RyanJMah/fydp-anchor-pcb/UWB_Anchor/Project Outputs for UWB_Anchor/BOM/Bill of Materials-UWB_Anchor.xlsx

Designator | Value | Footprint | Manufacturer | Manufacturer Part Number | Supplier | Supplier Part Number | Quantity
C1 | 22nF | 0603 - Capacitor | Samsung Electro-Mechanics | CL10B223KB8NNNC | JLCPCB | C21122 | 1
C2, C5 | 6.8nF | 0603 - Capacitor | FH (Guangdong Fenghua Advanced Tech) | 0603B682K500NT | JLCPCB | C1631 | 2
C3 | 1nF/2kV | 1206 - Capacitor | FH (Guangdong Fenghua Advanced Tech) | 1206B102K202NT | JLCPCB | C9196 | 1
C4, C33 | 10nF | 0603 - Capacitor | FH (Guangdong Fenghua Advanced Tech) | 0603B103K500NT | JLCPCB | C57112 | 2
C6 | 100uF | CAPPRD350W60D825H1300 | Lelon | RGA101M1HBK-0811G | Mouser | 140-RGA101M1HBK0811G | 1
C7, C8, C9, C19, C27, C28 | 10uF | 0603 - Capacitor | YAGEO | CC0603KRX7R9BB104 | JLCPCB | C14663 | 6
C10, C12, C20, C21, C22, C23, C24, C25, C26, C29 | 0.1uF | 0603 - Capacitor | YAGEO | CC0603KRX7R9BB104 | JLCPCB | C14663 | 10
C11, C14, C15, C16 | DNP | 0603 - Capacitor |  |  |  |  | 4
C13 | 1uF | 0603 - Capacitor | Samsung Electro-Mechanics | CL10A105KB8NNNC | JLCPCB | C15849 | 1
C17, C18 | 330pF | 0603 - Capacitor | Samsung Electro-Mechanics | CL10C331JB8NNNC | JLCPCB | C1664 | 2
C30, C31 | 10pF | 0603 - Capacitor | Samsung Electro-Mechanics | CL10C100JB8NNNC | JLCPCB | C1634 | 2
C32 | 4.7uF | 0603 - Capacitor | Samsung Electro-Mechanics | CL10A475KO8NNNC | JLCPCB | C19666 | 1
D1 |  | FP-SMAJ-MFG | Murata Electronics | BLM21AG121SH1D | Mouser | 81-BLM21AG121SH1D | 1
D2, D3, D4, D5, D6 |  | 0805 LED | Foshan NationStar Optoelectronics, Hubei KENTO Elec | NCD0805R1, C2297, C2296 | JLCPCB | C84256, C2297, C2296 | 5
F1, F2 |  | Wurth_0_MFG | Wurth Elektronik | 696101000002 | Mouser | 710-696101000002 | 2
FB1 |  | FP-BLM21-0_2-t0_85-e0_5-MFG | Murata Electronics | BLM21AG121SH1D | Mouser | 81-BLM21AG121SH1D | 1
J1 |  | ARJP11A-MASA-B-A-EMU2 | ABRACON | ARJP11A-MASA-B-A-EMU2 | Mouser | 815-RJP11AMASABAEMU2 | 1
J2 |  | HDR1X4 |  |  |  |  | 1
J3 |  | HDR1X3 |  |  |  |  | 1
J4, J5, J6, J7, J8, J9 |  | HDR1X2 |  |  |  |  | 6
L1 |  | FP-DFE252010C-IPC_A | Murata Electronics | DFE252010P-2R2M=P2 | JLCPCB | C882952 | 1
Q1, Q2 |  | ONSC-SOT-23-3-318-08_V | On Semiconductor | MGSF2N02ELT1G | JLCPCB | C236232 | 2
R1, R2, R15, R16, R17, R18, R19, R22, R23 | 1k | 0603 - Resistor | UNI-ROYAL(Uniroyal Elec) | 0603WAF1001T5E | JLCPCB | C21190 | 9
R3, R7, R8, R12 | 49.9 | 0603 - Resistor | UNI-ROYAL(Uniroyal Elec) | 0603WAF499JT5E | JLCPCB | C23185 | 4
R4, R6, R9, R11 | 33 | 0603 - Resistor | UNI-ROYAL(Uniroyal Elec) | 0603WAF330JT5E | JLCPCB | C23140 | 4
R5 | 10 | 0603 - Resistor | UNI-ROYAL(Uniroyal Elec) | 0603WAF100JT5E | JLCPCB | C22859 | 1
R10 | 0 | 0603 - Resistor | UNI-ROYAL(Uniroyal Elec) | 0603WAF0000T5E | JLCPCB | C21189 | 1
R13, R14 | 100 / 0.25W | RESAD1100W55L680D260 |  |  |  |  | 2
R20, R21, R34 | DNP | 0603 - Resistor |  |  |  |  | 3
R24, R25 | 100k | 0603 - Resistor | UNI-ROYAL(Uniroyal Elec) | 0603WAF1003T5E | JLCPCB | C25803 | 2
R26 | 1M | 0603 - Resistor | UNI-ROYAL(Uniroyal Elec) | 0603WAF1004T5E | JLCPCB | C22935 | 1
R27, R28, R30, R31, R32, R33, R35 | 10k | 0603 - Resistor | UNI-ROYAL(Uniroyal Elec) | 0603WAF1002T5E | JLCPCB | C25804 | 7
R29 | 2.4k | 0603 - Resistor | UNI-ROYAL(Uniroyal Elec) | 0603WAF2401T5E | JLCPCB | C22940 | 1
S1, S2 |  | SW_TS-1187A-B-A-B | XKB Connectivity | TS-1187A-B-A-B | JLCPCB | C318884 | 2
U1 |  | Ag9900m | Silvertel | Ag9905M | Mouser | 480-AG9905M | 1
U2 |  | DCY0004A_N | Texas Instruments | TLV1117LV33DCYR | JLCPCB | C15578 | 1
U3 |  | DWM3001C | Qorvo | DWM3001C | Qorvo | DWM3001C | 1
U4 |  | W5500 | WIZNET | W5500 | JLCPCB | C32843 | 1
Y1 | 25MHz | XTAL_TSX-3225_25.0000MF20P-C0 | Yangxing Tech | X322525MOB4SI | JLCPCB | C9006 | 1
