RyanJMah/fydp-anchor-pcb/UWB_Anchor/Project Outputs for UWB_Anchor/PDF/UWB_Anchor.PDF

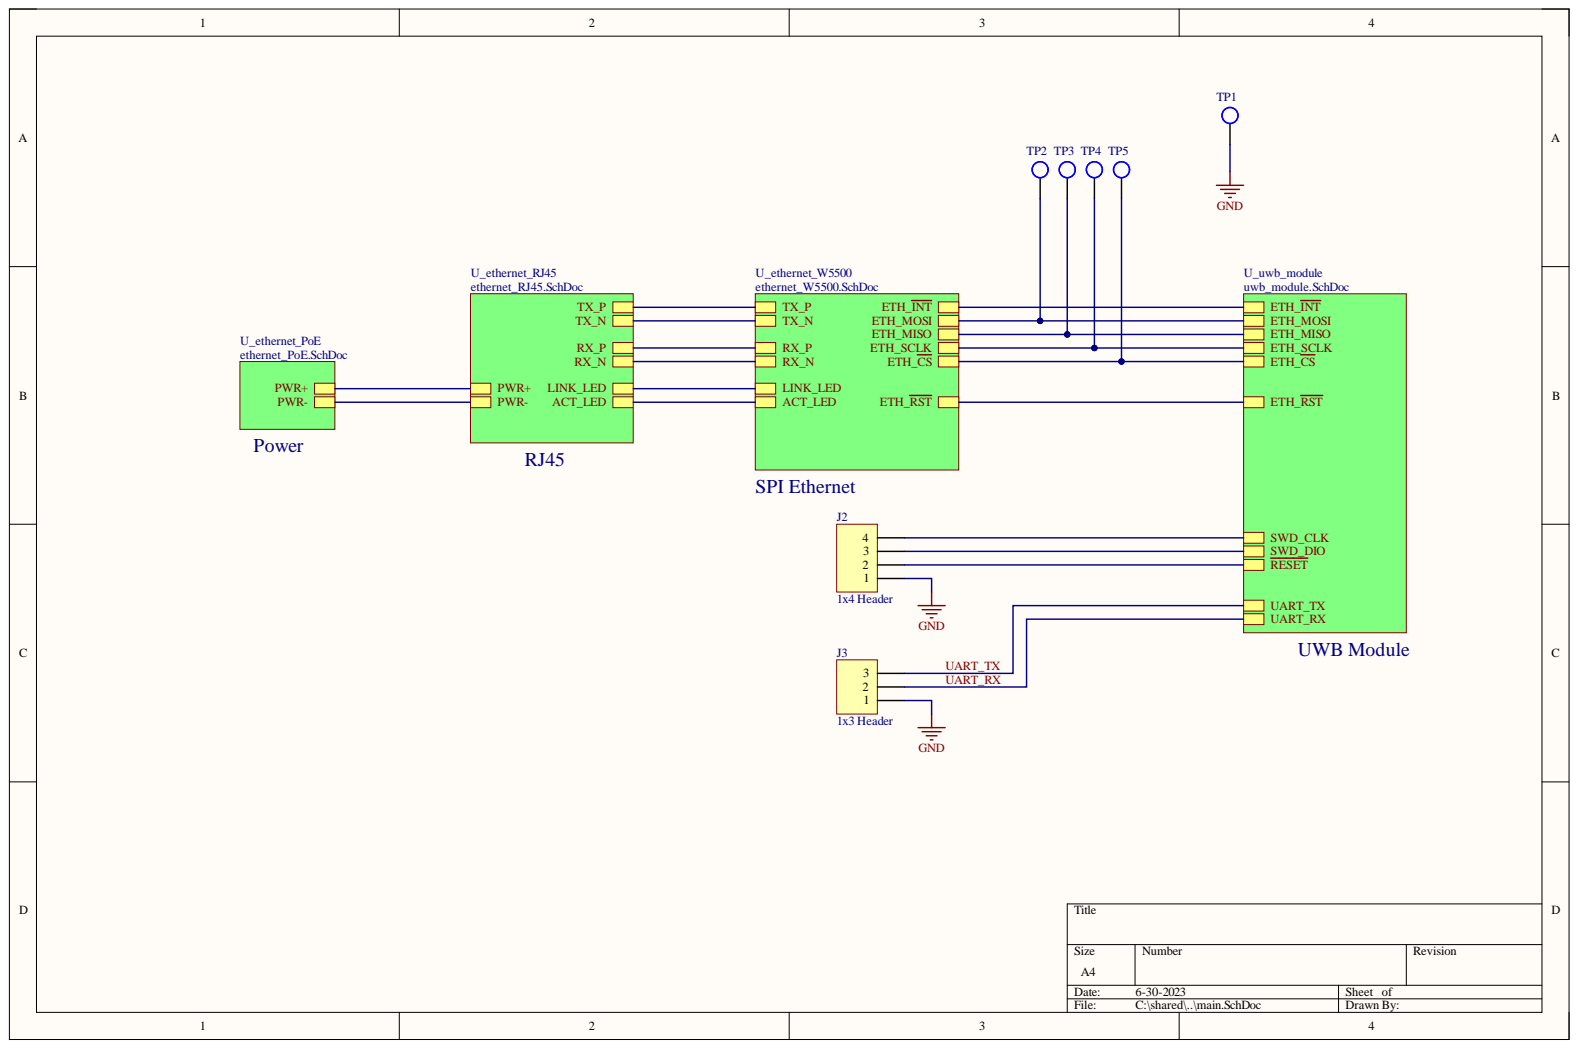
[picture p1: page 1]

Size A4 | Number | Revision

Date: 6-30-2023 | Sheet of
File: C:\shared\..\main.SchDoc | Drawn By:

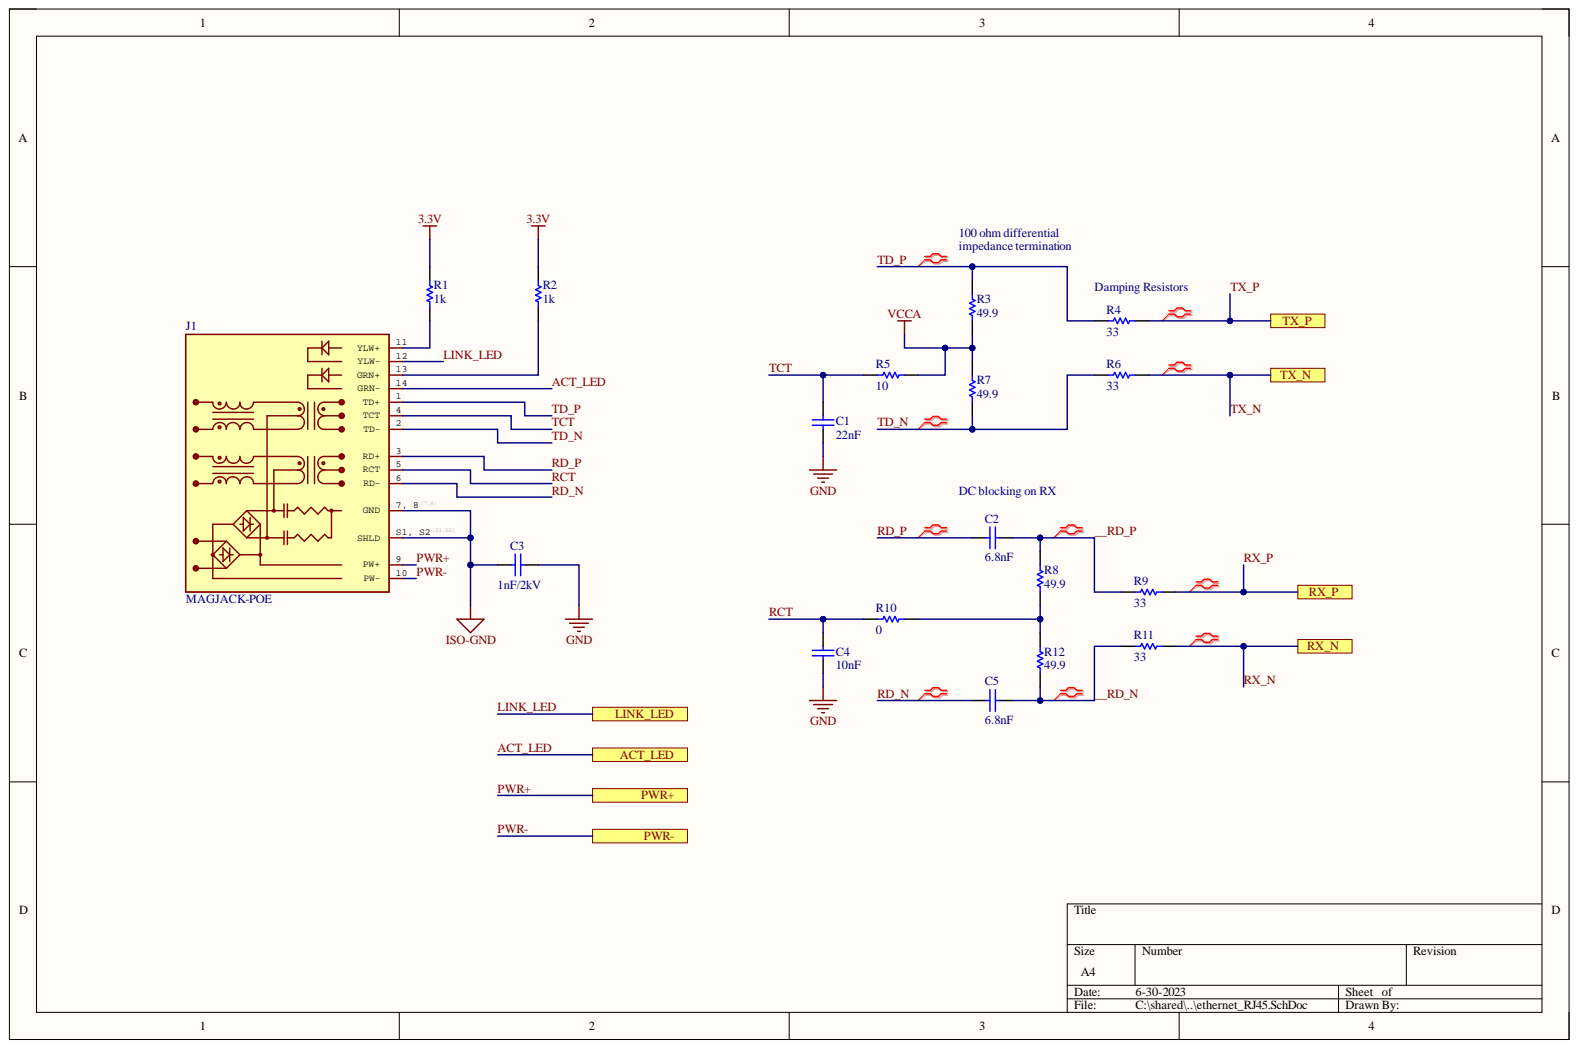
[picture p2: page 2]

Siz e A4 | Numb e r | R evisio n

Da te : 6-30-2 0 2 3 | She et of
File : C:\sha r ed\. .\ethe rnet_R J4 5 . S c hD o c | Dr awn By:

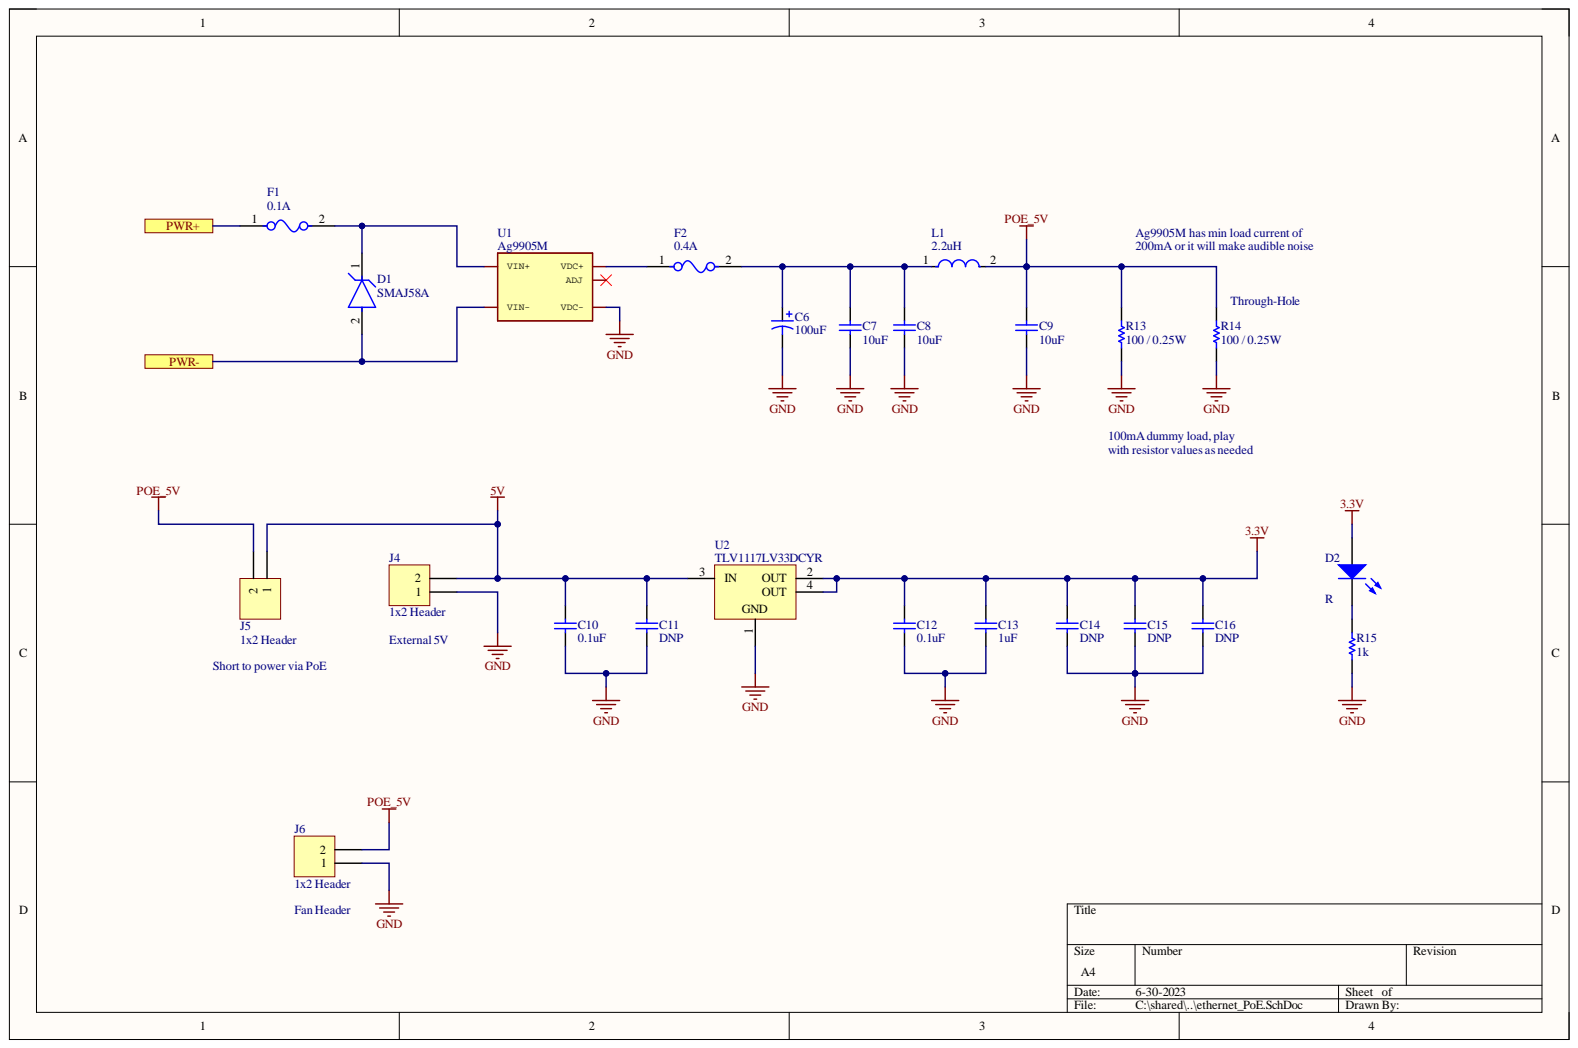
[picture p3: page 3]

Ag9905M has min load current of
200mA or it will make audible noise

100mA dummy load, play
with resistor values as needed

Size A4 | Number | Revision

Date: 6-30-2023 | Sheet of
File: C:\shared\..\ethernet_PoE.SchDoc | Drawn By:

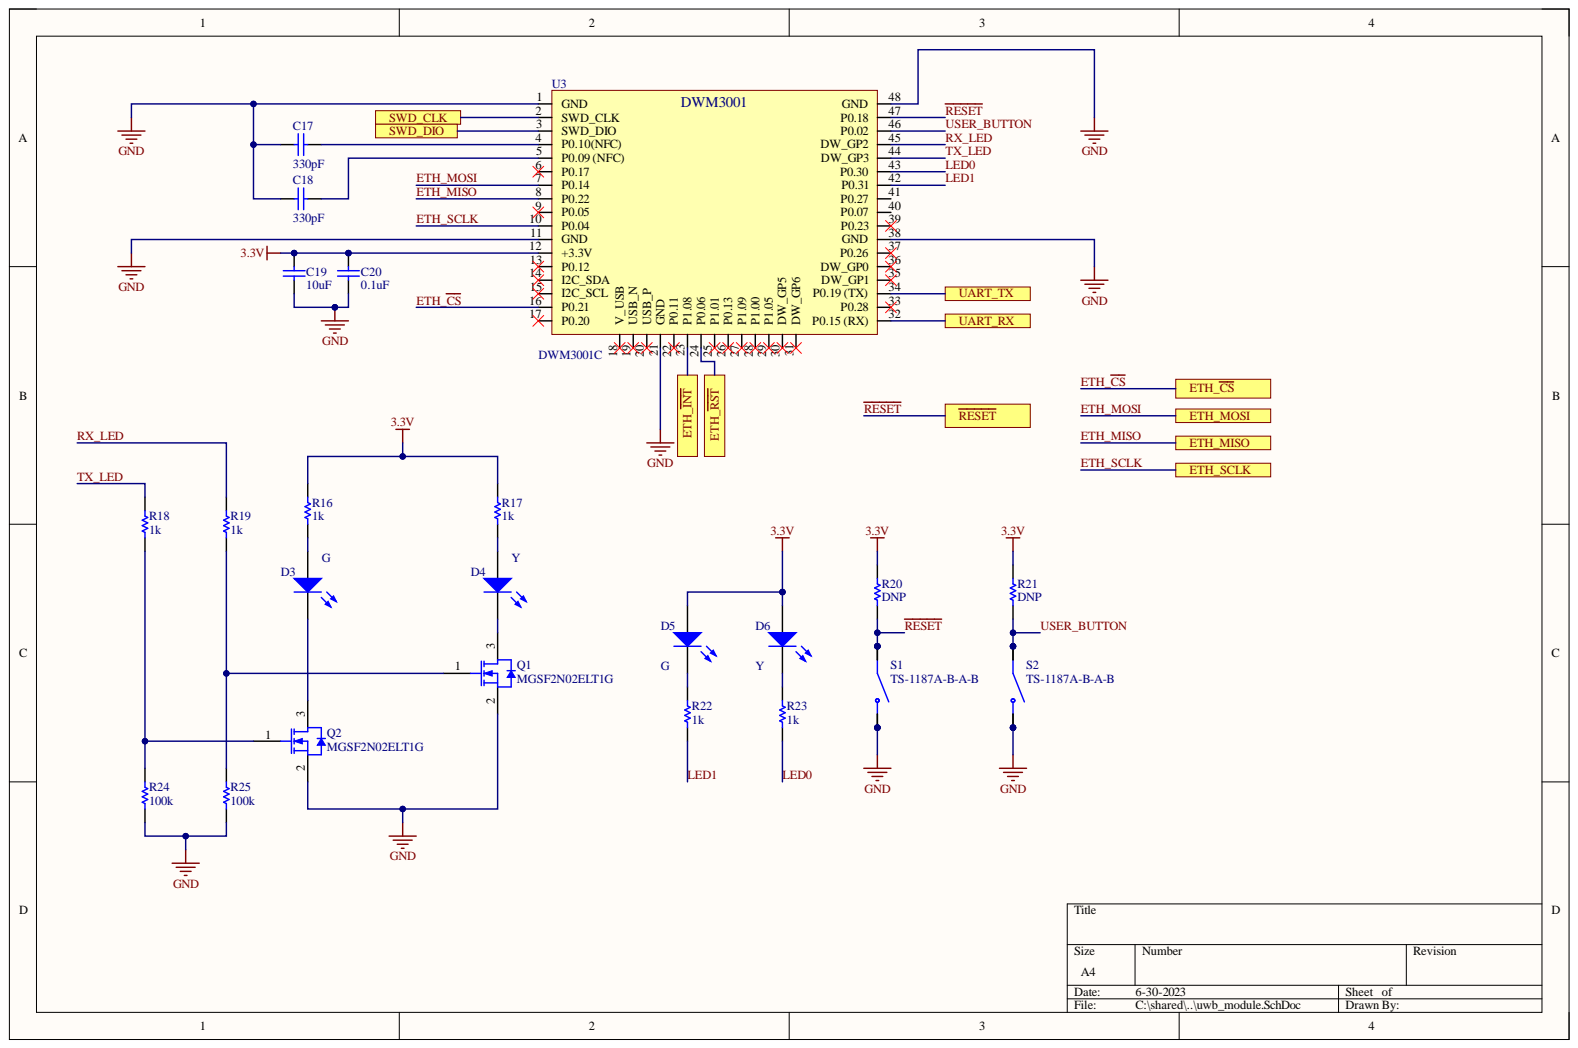
[picture p4: page 4]

Siz e A4 | Numb e r | R evisio n

Da te : 6-30-2 0 2 3 | She et of
File : C:\sha r ed\. .\uwb_modul e . S c hD o c | Dr awn By:

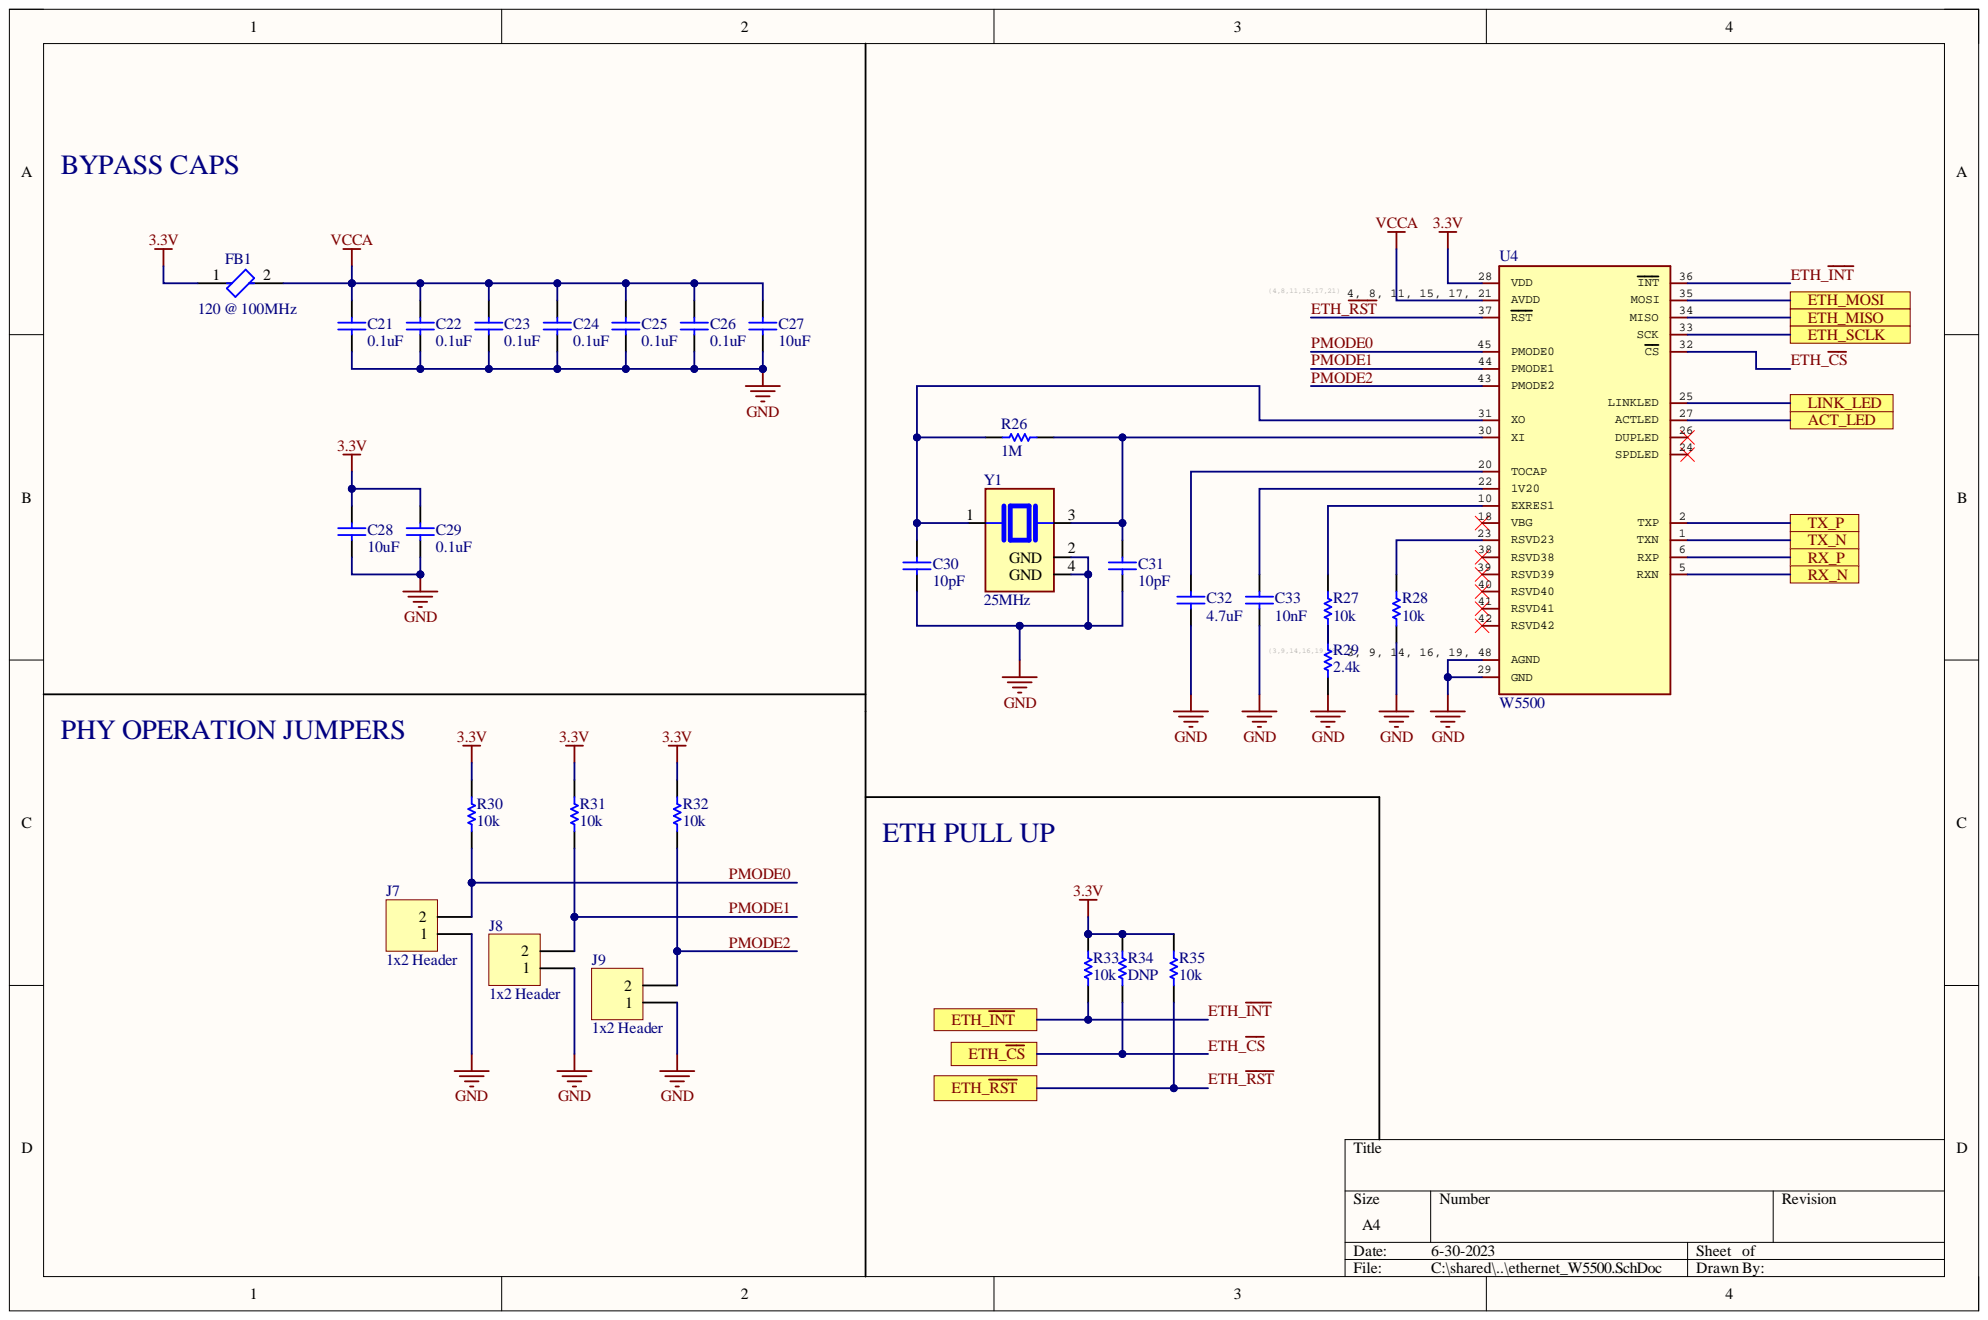
[picture p5: page 5]

1V20 22
EXRES1 10
VBG 18

Siz e A4 | Numb e r | R evisio n

Da te : 6-30-2 0 2 3 | She et of
File : C:\sha r ed\. .\ethe rnet_W 5 5 0 0 . S c hD o c | Dr awn By:

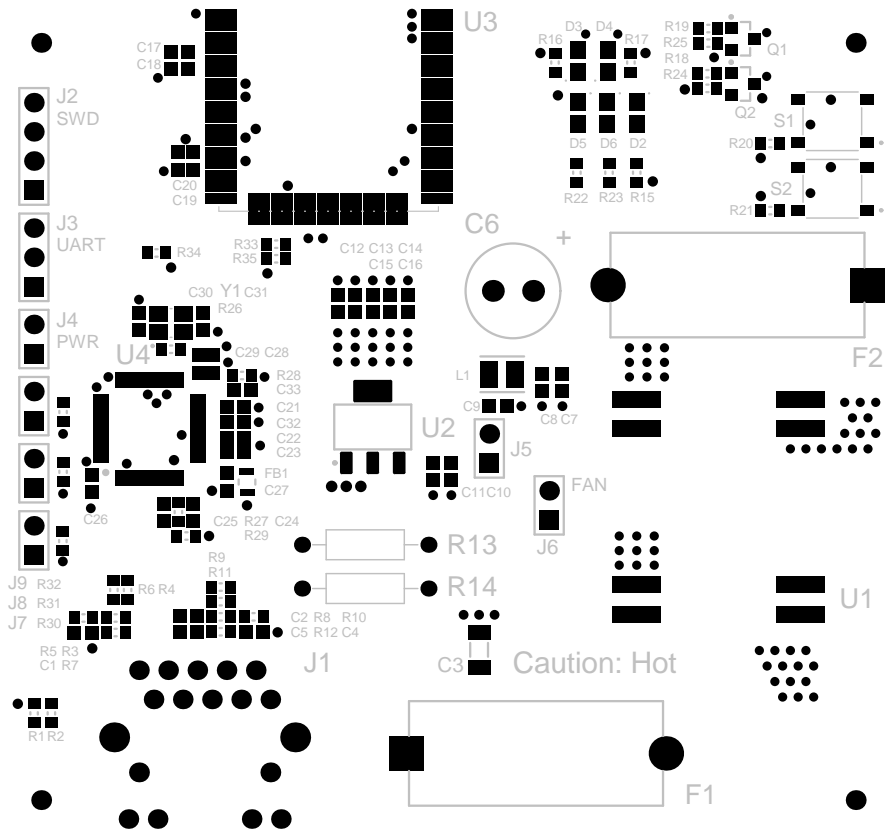
[picture p6: page 6]

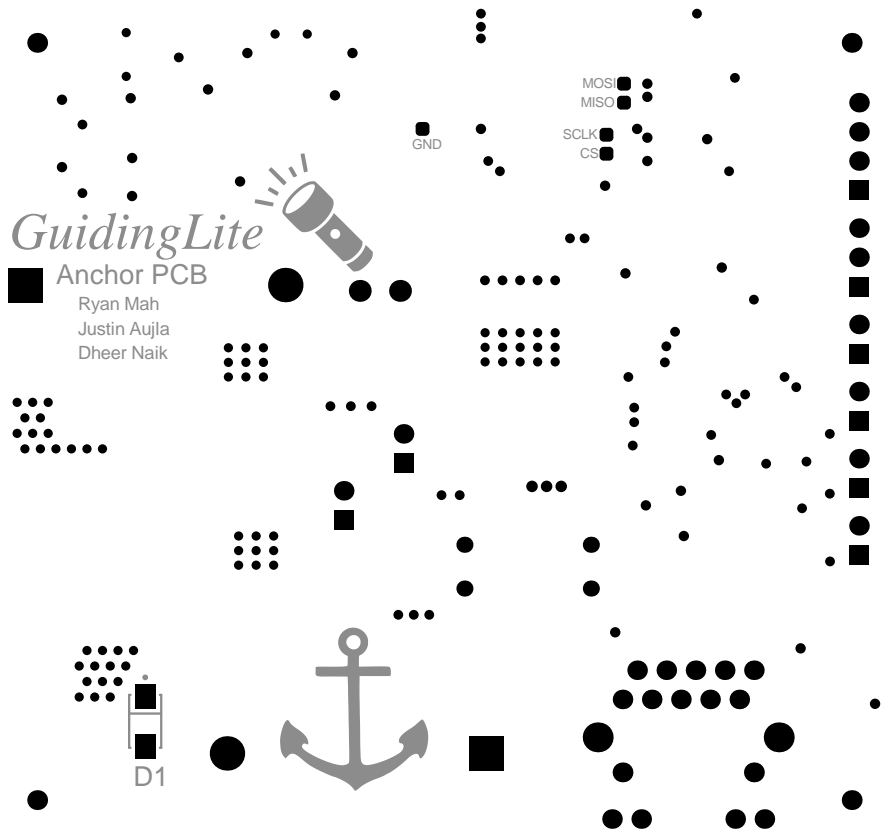
[picture p7: page 7]
