RyanJMah/fydp-anchor-pcb/(list of files, drawings)

Other design files:
UWB_Anchor/board.PcbDoc
UWB_Anchor/ethernet_PoE.SchDoc
UWB_Anchor/ethernet_RJ45.SchDoc
UWB_Anchor/ethernet_W5500.SchDoc
UWB_Anchor/main.SchDoc
UWB_Anchor/UWB_Anchor.PrjPcb
UWB_Anchor/uwb_module.SchDoc
