RyanJMah/fydp-anchor-pcb/(commit log)

2023-06-02 I fucked up and had to force push but if u have a problem with that then fuck u
    [UWB_Anchor.PrjPcb, ethernet.SchDoc, main.SchDoc]
2023-06-02 more ethernet changes
    [UWB_Anchor.PrjPcb, ethernet.SchDoc, ethernet_RJ45.SchDoc, main.SchDoc]
2023-06-03 idk what I did tbh
    [UWB_Anchor.PrjPcb, ethernet_PoE.SchDoc, ethernet_RJ45.SchDoc, main.SchDoc]
2023-06-04 added dwm schematic
    [uwb_module.SchDoc]
2023-06-05 merged dheer into master
    [main.SchDoc]
2023-06-06 pushing so justin can merge
    [UWB_Anchor.PrjPcb, ethernet_PoE.SchDoc, ethernet_RJ45.SchDoc, main.SchDoc, uwb_module.SchDoc]
2023-06-06 w5500 sch
    [ethernet_W5500.SchDoc]
2023-06-06 ryans problem now
    [ethernet_W5500.SchDoc, main.SchDoc, uwb_module.SchDoc]
2023-06-06 deez nuts
    [UWB_Anchor.PrjPcb, main.SchDoc]
2023-06-11 added outjob, fixed schematic lib ports, and re-annotated
    [UWB_Anchor.PrjPcb, ethernet_PoE.SchDoc, ethernet_RJ45.SchDoc, ethernet_W5500.SchDoc, uwb_module.SchDoc]
2023-06-11 passives for rj45 and w5500
    [ethernet_RJ45.SchDoc, ethernet_W5500.SchDoc]
2023-06-11 make ports not ugly
    [ethernet_PoE.SchDoc, ethernet_RJ45.SchDoc, ethernet_W5500.SchDoc, uwb_module.SchDoc]
2023-06-11 finished schematics (some passives still need spec tho)
    [UWB_Anchor.PrjPcb, ethernet_PoE.SchDoc, ethernet_RJ45.SchDoc, ethernet_W5500.SchDoc, main.SchDoc, uwb_module.SchDoc]
2023-06-11 i lied
    [ethernet_PoE.SchDoc, ethernet_W5500.SchDoc]
2023-06-12 done I think
    [UWB_Anchor.PrjPcb, ethernet_PoE.SchDoc, ethernet_RJ45.SchDoc, ethernet_W5500.SchDoc, main.SchDoc, uwb_module.SchDoc]
2023-06-12 import schematics into pcb
    [UWB_Anchor.PrjPcb, board.PcbDoc, main.SchDoc]
2023-06-13 started placement
    [UWB_Anchor.PrjPcb, board.PcbDoc, ethernet_W5500.SchDoc, uwb_module.SchDoc]
2023-06-24 clean up
    [UWB_Anchor.PrjPcb]
2023-06-24 idk what i did
    [Bill of Materials-UWB_Anchor.xlsx, Pick Place for board.csv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]
2023-06-24 jlc pick and place seems to kinda work
    [Bill of Materials-UWB_Anchor.xlsx, Pick Place for board.csv, UWB_Anchor.PrjPcb, ethernet_W5500.SchDoc, uwb_module.SchDoc]
2023-06-26 added fan
    [UWB_Anchor.PrjPcb, ethernet_PoE.SchDoc, ethernet_W5500.SchDoc]
2023-06-28 idk what I did (MIGHT HAVE TO REVERT THIS COMMIT LOL)
    [ethernet_PoE.SchDoc, uwb_module.SchDoc]
2023-06-30 final commit before order
    [main.SchDoc, uwb_module.SchDoc]
